VladxIL/NMEA2000_0183_Display/Media/CAN_DISPLAY.png

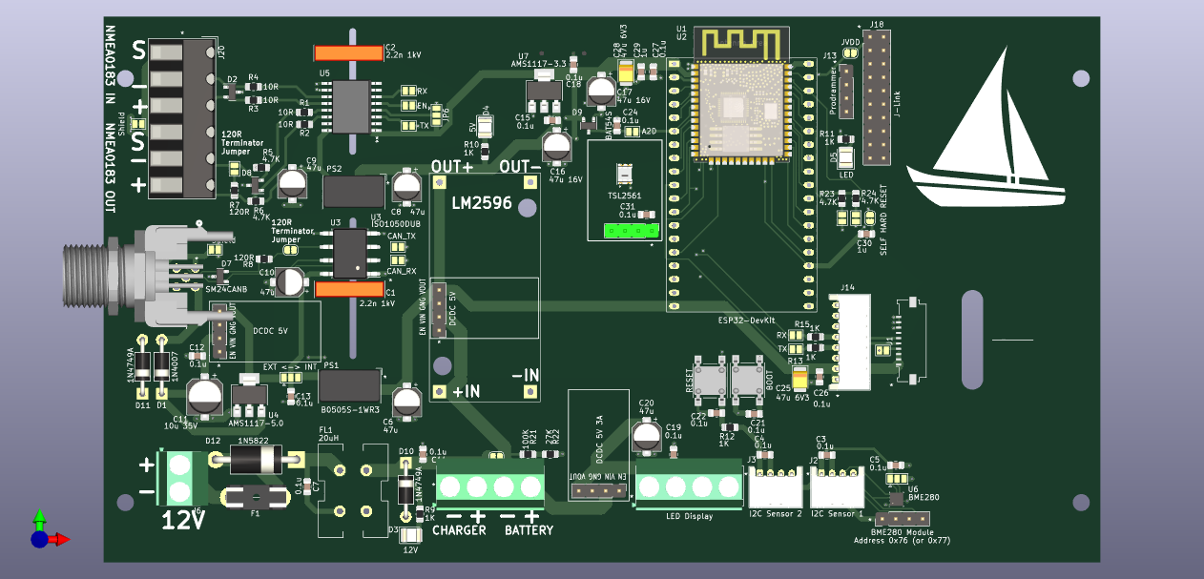
Media/CAN_DISPLAY.png
