VladxIL/NMEA2000_0183_Display/README.md

# NMEA2000_0183_Display
Display NMEA2000 and NMEA0183 on DWIN 7" Display
