VladxIL/NMEA2000_0183_Display/VersionsInfo.txt

Hardware Version 1.0 - PCB Release Candidate
	ESP32-WROOM-32
	Galvanic isolated CAN BUS
	Galvanic isolated RS422 Input and Output
	DWWIN UART interface.
1	
Firmware Version 1.0
	Not implemented yet
