VladxIL/NMEA2000_0183_Display/BOM/AUTOBOM LED Matrix Display.csv

Source: | C:\Vladi\MyProjects\NMEA2000_0183_Display\LED Matrix Display\LED Matrix Display.kicad_sch
Date: | 11/20/2023 10:49:28 AM
Tool: | Eeschema 7.0.8
Generator: | C:\Program Files\KiCad\7.0\bin\scripting\plugins/bom_csv_grouped_by_value_with_fp.py
Component Count: | 37
Ref | Qnty | Value | Cmp name | Footprint | Description | Vendor | DNP
C1 | 1 | 0.1uF | C_Small | Capacitor_SMD:C_0402_1005Metric | Unpolarized capacitor, small symbol
C2, C3, C5, C6, C8, C9, C13, C14, C15 | 9 | 0.1u | C_Small | Capacitor_SMD:C_0805_2012Metric_Pad1.18x1.45mm_HandSolder | Unpolarized capacitor, small symbol
C4, C10 | 2 | 1u | C_Small | Capacitor_SMD:C_0805_2012Metric_Pad1.18x1.45mm_HandSolder | Unpolarized capacitor, small symbol
C11 | 1 | 47u 6V3 | C_Polarized_Small | Capacitor_Tantalum_SMD:CP_EIA-3528-21_Kemet-B_Pad1.50x2.35mm_HandSolder | Polarized capacitor, small symbol
C12, C16 | 2 | 47u 16V | C_Polarized_Small | Capacitor_SMD:CP_Elec_5x5.8 | Polarized capacitor, small symbol
D1 | 1 | WS2812B | WS2812B | LED_SMD:LED_WS2812B_PLCC4_5.0x5.0mm_P3.2mm | RGB LED with integrated controller
D2 | 1 | BAT54S | BAT54S | Package_TO_SOT_SMD:SOT-23 | Vr 30V, If 200mA, Dual schottky barrier diode, in series, SOT-323
D3 | 1 | LED | LED_Small | LED_SMD:LED_0805_2012Metric_Pad1.15x1.40mm_HandSolder | Light emitting diode, small symbol
J1 | 1 | I2C Sensor 1 | Conn_01x04 | Connector_JST:JST_PH_S4B-PH-SM4-TB_1x04-1MP_P2.00mm_Horizontal | Generic connector, single row, 01x04, script generated (kicad-library-utils/schlib/autogen/connector/)
J2 | 1 | Prodrammer | Conn_01x04 | Connector_JST:JST_PH_S4B-PH-SM4-TB_1x04-1MP_P2.00mm_Horizontal | Generic connector, single row, 01x04, script generated (kicad-library-utils/schlib/autogen/connector/)
J4 | 1 | IN | Screw_Terminal_01x04 | Connector_Molex:Molex_Micro-Fit_3.0_43650-0415_1x04_P3.00mm_Vertical | Generic screw terminal, single row, 01x04, script generated (kicad-library-utils/schlib/autogen/connector/)
J6 | 1 | OUT | Screw_Terminal_01x04 | Connector_Molex:Molex_Micro-Fit_3.0_43650-0415_1x04_P3.00mm_Vertical | Generic screw terminal, single row, 01x04, script generated (kicad-library-utils/schlib/autogen/connector/)
J7 | 1 | MINI560 | Screw_Terminal_01x04 | 1Display:Mini560_DC_StepDown | Generic screw terminal, single row, 01x04, script generated (kicad-library-utils/schlib/autogen/connector/)
JP2 | 1 | SELF HARD RESET | SolderJumper_2_Open | Jumper:SolderJumper-2_P1.3mm_Open_RoundedPad1.0x1.5mm | Solder Jumper, 2-pole, open
LED1 | 1 | TSL2561 | TSL25723FN | 1Display:TSL2561
R1, R6 | 2 | 1K | R_Small | Resistor_SMD:R_0805_2012Metric_Pad1.20x1.40mm_HandSolder | Resistor, small symbol
R2, R3 | 2 | 4.7K | R_Small | Resistor_SMD:R_0805_2012Metric_Pad1.20x1.40mm_HandSolder | Resistor, small symbol
R4 | 1 | 100K | R_Small | Resistor_SMD:R_0805_2012Metric_Pad1.20x1.40mm_HandSolder | Resistor, small symbol
R5 | 1 | 27K | R_Small | Resistor_SMD:R_0805_2012Metric_Pad1.20x1.40mm_HandSolder | Resistor, small symbol
SW1 | 1 | BOOT | SW_Push | Button_Switch_SMD:SW_Push_1P1T_NO_6x6mm_H9.5mm | Push button switch, generic, two pins
SW2 | 1 | RESET | SW_Push | Button_Switch_SMD:SW_Push_1P1T_NO_6x6mm_H9.5mm | Push button switch, generic, two pins
SW3 | 1 | SW_Reed | SW_Reed | Button_Switch_SMD:SW_SPST_REED_CT05-XXXX-J1 | reed switch
U1 | 1 | ESP32-WROOM-E | ESP32-WROOM-E | PCM_Espressif:ESP32-WROOM-32E | ESP32-WROOM-32E integrates ESP32-D0WD-V3, with higher stability and safety performance.
U2 | 1 | BME280 | BME280 | Package_LGA:Bosch_LGA-8_2.5x2.5mm_P0.65mm_ClockwisePinNumbering | 3-in-1 sensor, humidity, pressure, temperature, I2C and SPI interface, 1.71-3.6V, LGA-8
U4 | 1 | AMS1117-3.3 | AMS1117-5.0 | Package_TO_SOT_SMD:SOT-223-3_TabPin2 | 1A Low Dropout regulator, positive, 5.0V fixed output, SOT-223
