VladxIL/NMEA2000_0183_Display/CAN_DISPLAY/Footprints/c-1977223-6-b1-3d.stp

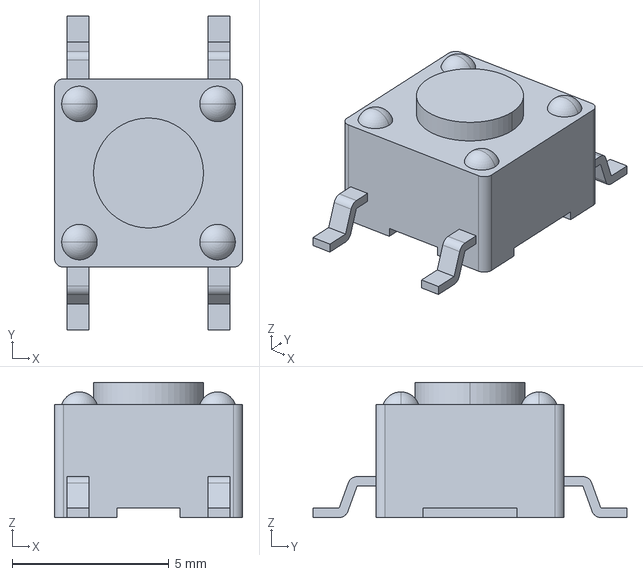
[picture p2: CAD file, 2023-11-14]
CAN_DISPLAY/Footprints/c-1977223-6-b1-3d.stp
6.00 x 10.0 x 4.30 mm
