VladxIL/NMEA2000_0183_Display/CAN_DISPLAY/Footprints/ul_ISO3080DW/DW0016B.stp

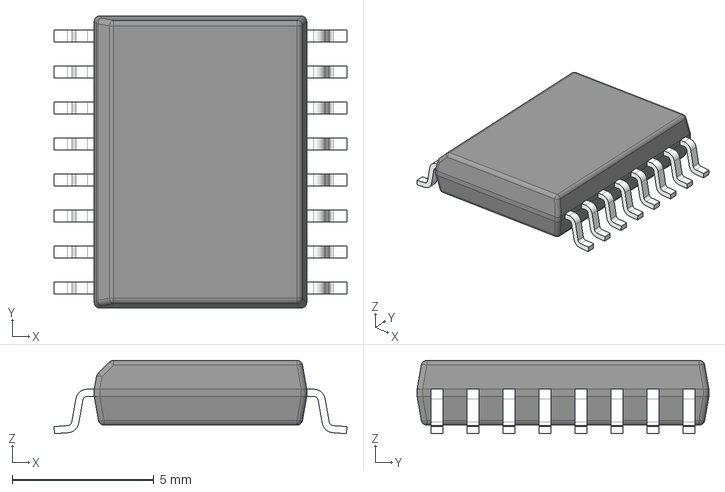
[picture p3: CAD file, 2023-11-12]
CAN_DISPLAY/Footprints/ul_ISO3080DW/DW0016B.stp
10.3 x 10.3 x 2.59 mm
BODY-SOIC
LEAD-DW0016 x 16
