VladxIL/NMEA2000_0183_Display/CAN_DISPLAY/Footprints/c-1825967-1-c-3d.stp

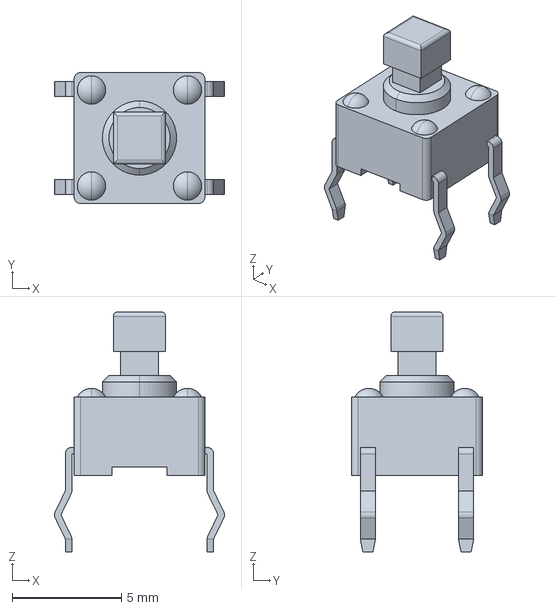
[picture p4: CAD file, 2023-11-14]
CAN_DISPLAY/Footprints/c-1825967-1-c-3d.stp
7.80 x 6.00 x 11.0 mm
