VladxIL/NMEA2000_0183_Display/CAN_DISPLAY/Footprints/M12.stp

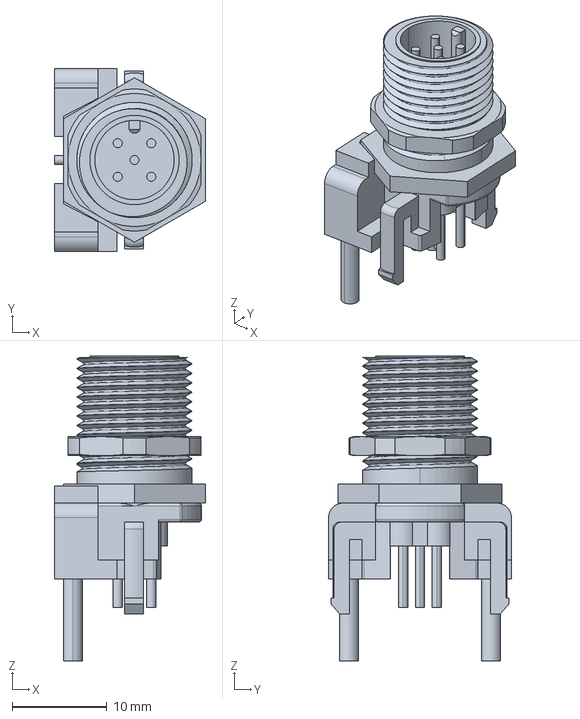
[picture p5: CAD file, 2023-11-14]
CAN_DISPLAY/Footprints/M12.stp
15.9 x 19.2 x 32.1 mm
