VladxIL/NMEA2000_0183_Display/CAN_DISPLAY/Footprints/Terminal4p.stp

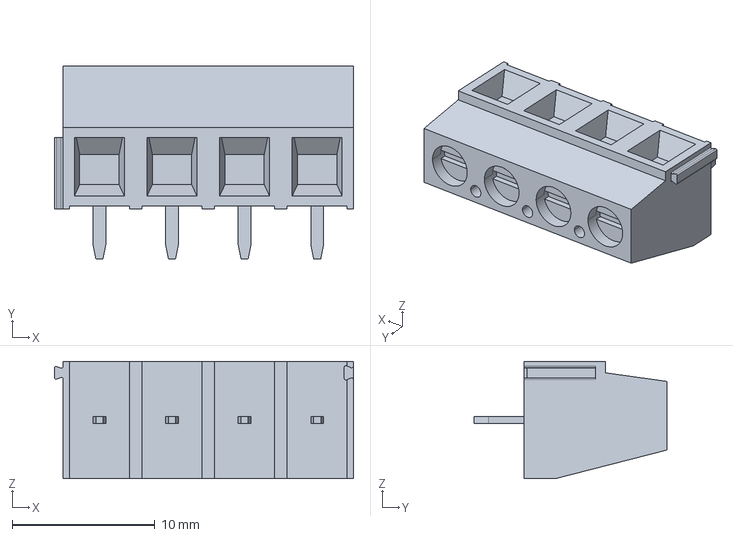
[picture p6: CAD file, 2023-11-14]
CAN_DISPLAY/Footprints/Terminal4p.stp
20.9 x 13.5 x 8.20 mm
