VladxIL/NMEA2000_0183_Display/Schematic/CAN_DISPLAY.pdf

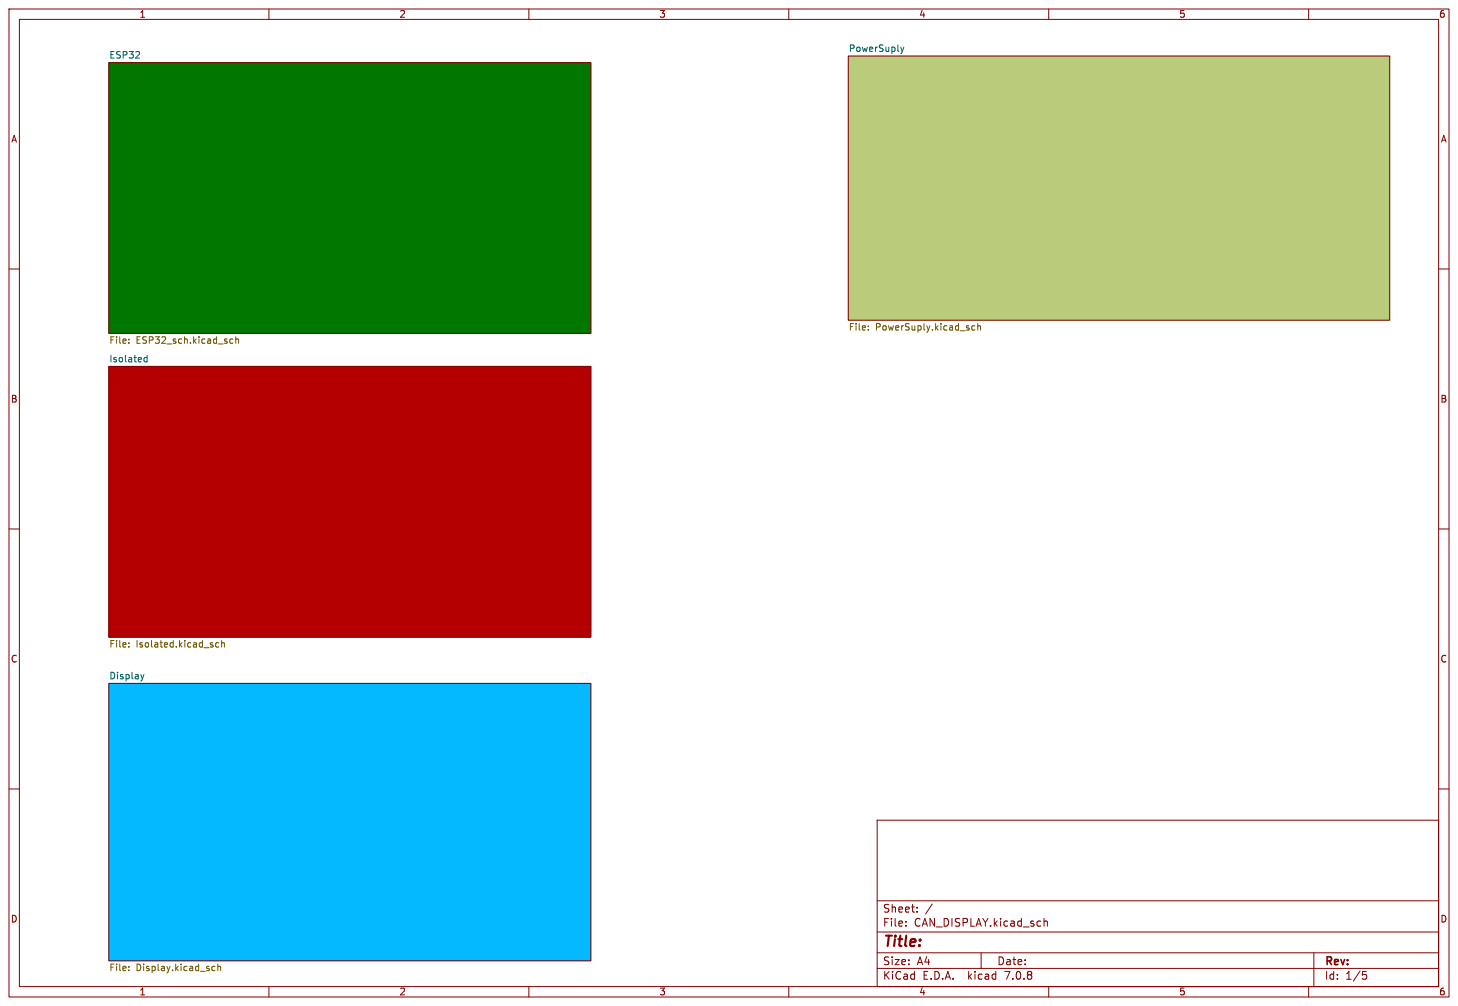
[picture p7: page 1]

PowerSuply File: PowerSuply.kicad_sch ESP32 File: ESP32_sch.kicad_sch Display File: Display.kicad_sch

Id: 1/5 Title: File: CAN_DISPLAY.kicad_sch Sheet: /

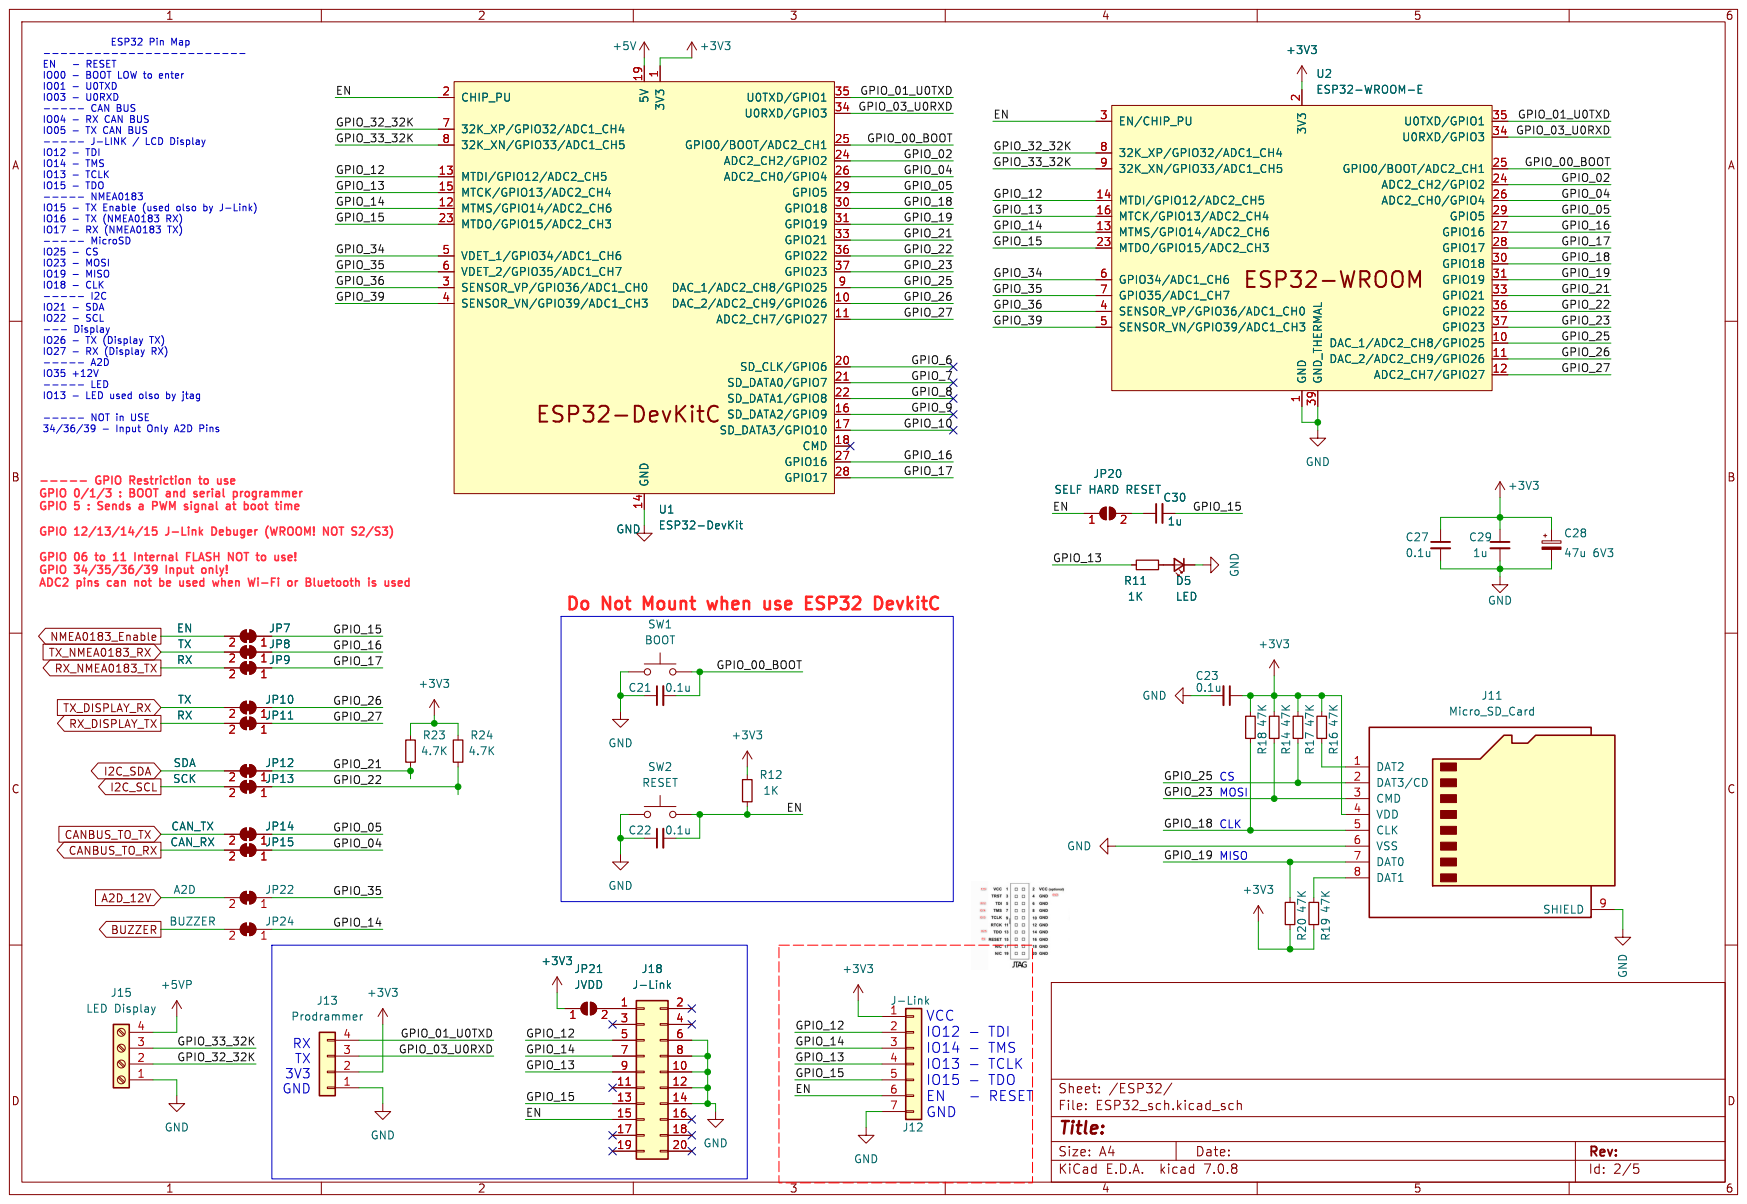
[picture p8: page 2]

1 DAC_2/ADC2_CH9/GPIO26 10 ADC2_CH7/GPIO27 11 MTMS/GPIO14/ADC2_CH6 12 MTDI/GPIO12/ADC2_CH5 13 MTCK/GPIO13/ADC2_CH4 15 SD_DATA2/GPIO9 16 SD_DATA3/GPIO10 17 CMD 18 CHIP_PU 2 SD_CLK/GPIO6 20 SD_DATA0/GPIO7 21 SD_DATA1/GPIO8 22 MTDO/GPIO15/ADC2_CH3 23 ADC2_CH2/GPIO2 24 GPIO0/BOOT/ADC2_CH1 25 ADC2_CH0/GPIO4 26 GPIO16 27 GPIO17 28 GPIO5 29 SENSOR_VP/GPIO36/ADC1_CH0 3 GPIO18 30 GPIO19 31 GPIO21 33 U0RXD/GPIO3 34 U0TXD/GPIO1 35 GPIO22 36 GPIO23 37 SENSOR_VN/GPIO39/ADC1_CH3 4 VDET_1/GPIO34/ADC1_CH6 5 VDET_2/GPIO35/ADC1_CH7 6

Do Not Mount when use ESP32 DevkitC

Id: 2/5 Title: File: ESP32_sch.kicad_sch Sheet: /ESP32/ R12

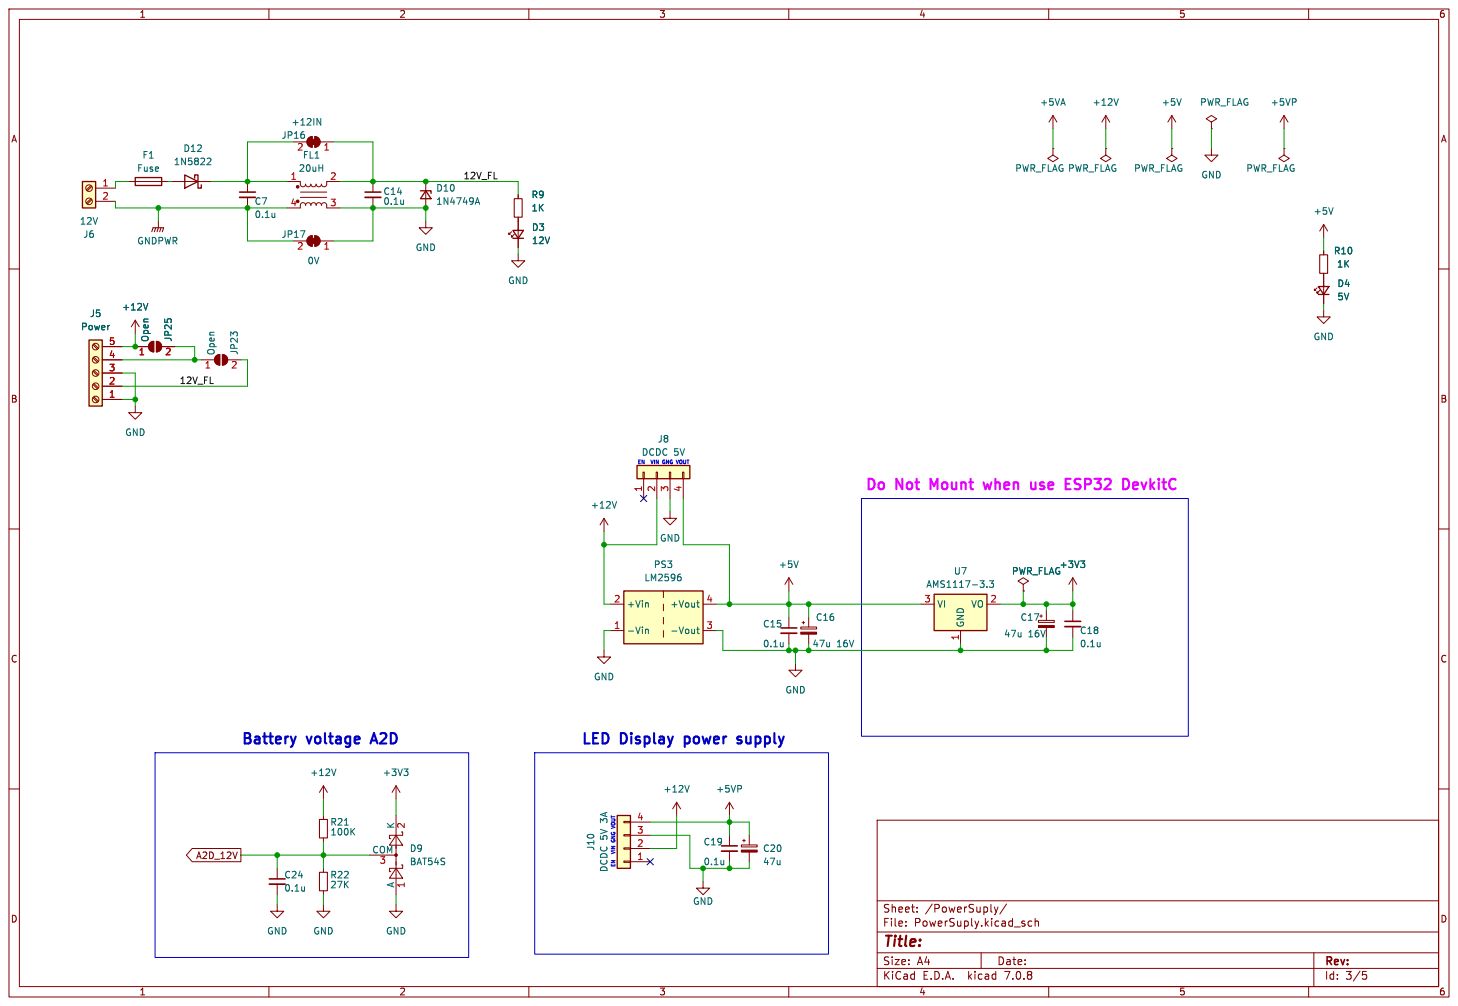
[picture p9: page 3]

Id: 3/5 Title: File: PowerSuply.kicad_sch Sheet: /PowerSuply/ GND GND

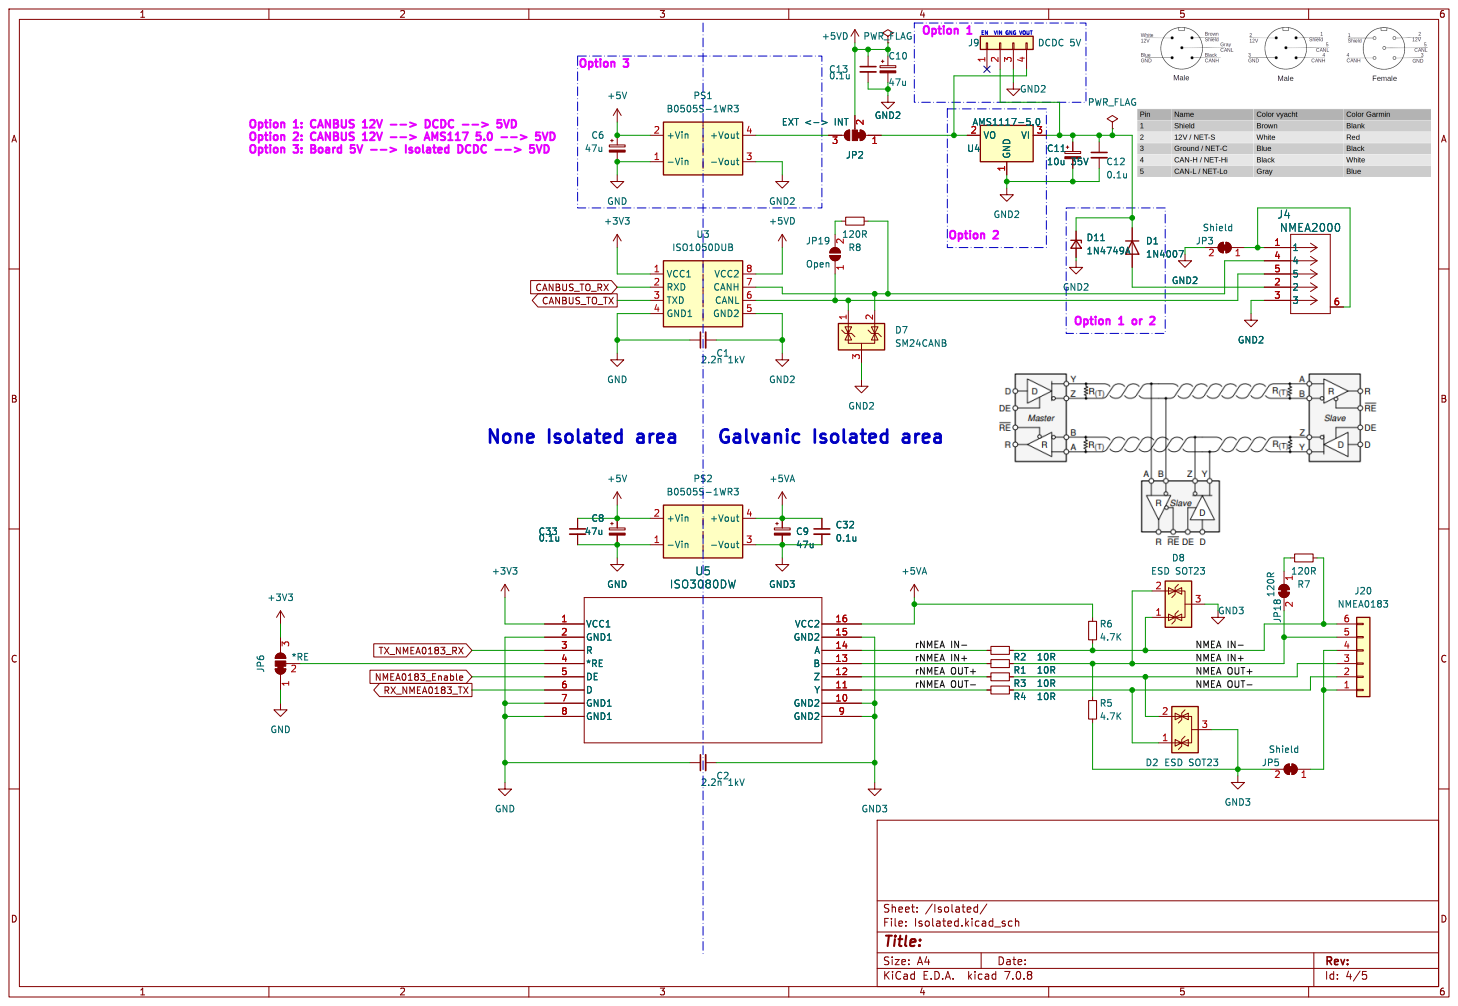
[picture p10: page 4]

1 VO 2 VI 3 U4AMS1117-5.0 VCC1 1 RXD 2 TXD 3 GND1 4 GND2 5 CANL 6 CANH 7 VCC2 8 U3

Id: 4/5 Title: File: Isolated.kicad_sch Sheet: /Isolated/ +3V3

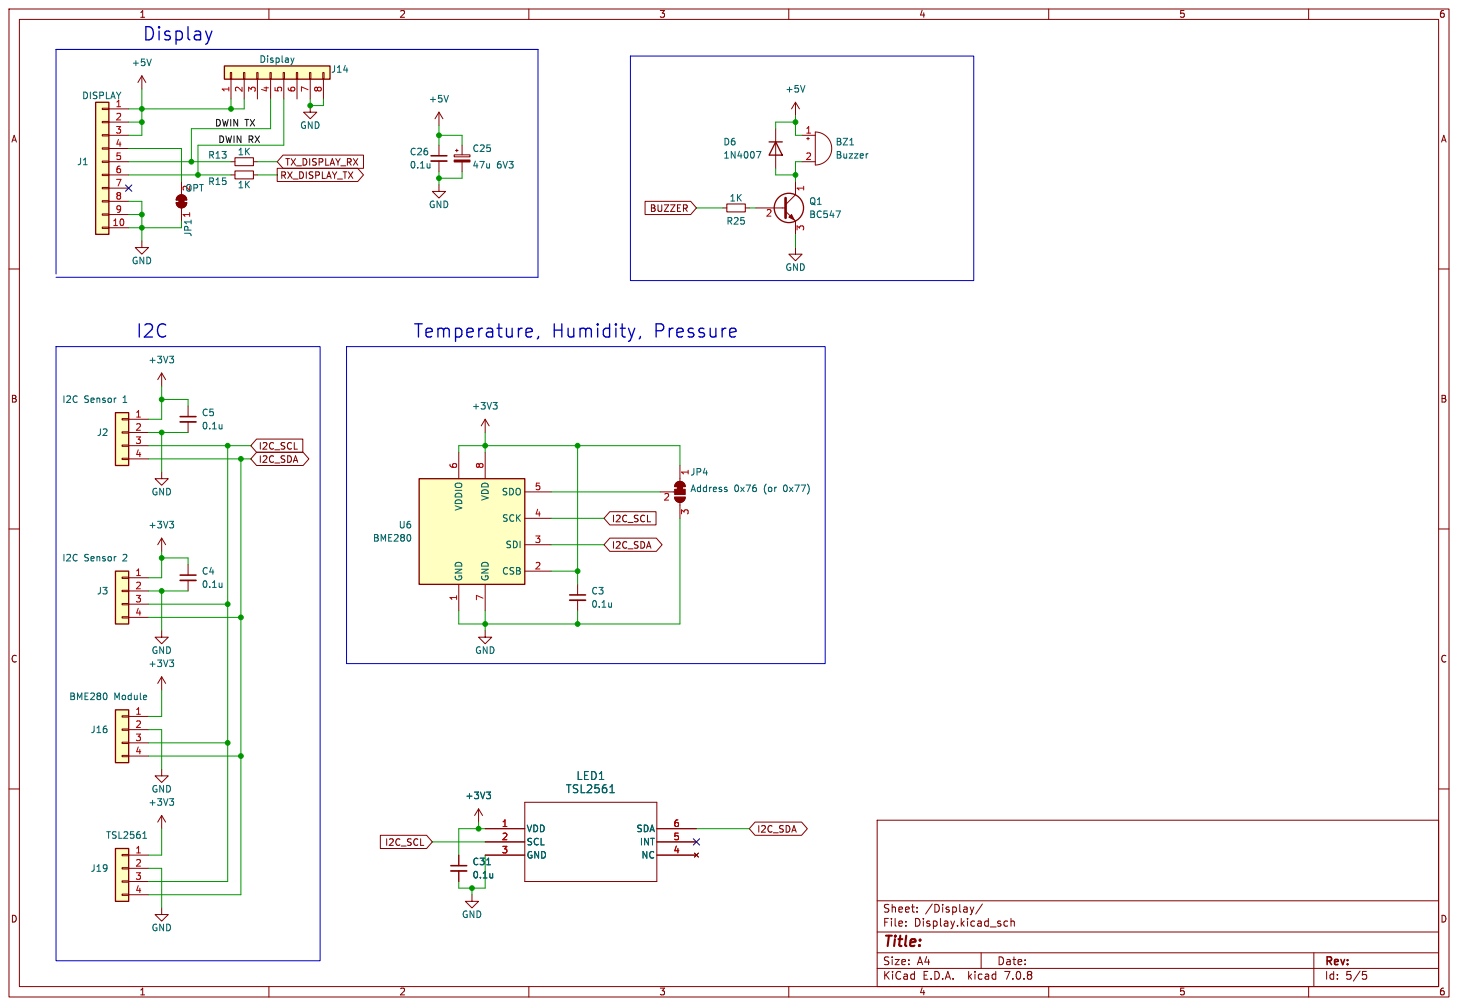
[picture p11: page 5]

DWIN RX DWIN TX

1 CSB 2 SDI 3 SCK 4 SDO 5 VDDIO

Id: 5/5 Title: File: Display.kicad_sch Sheet: /Display/
