VladxIL/NMEA2000_0183_Display/CAN_DISPLAY/CAN_DISPLAY.kicad_pcb

## KiCad design CAN_DISPLAY/CAN_DISPLAY.kicad_pcb (2023-11-15)

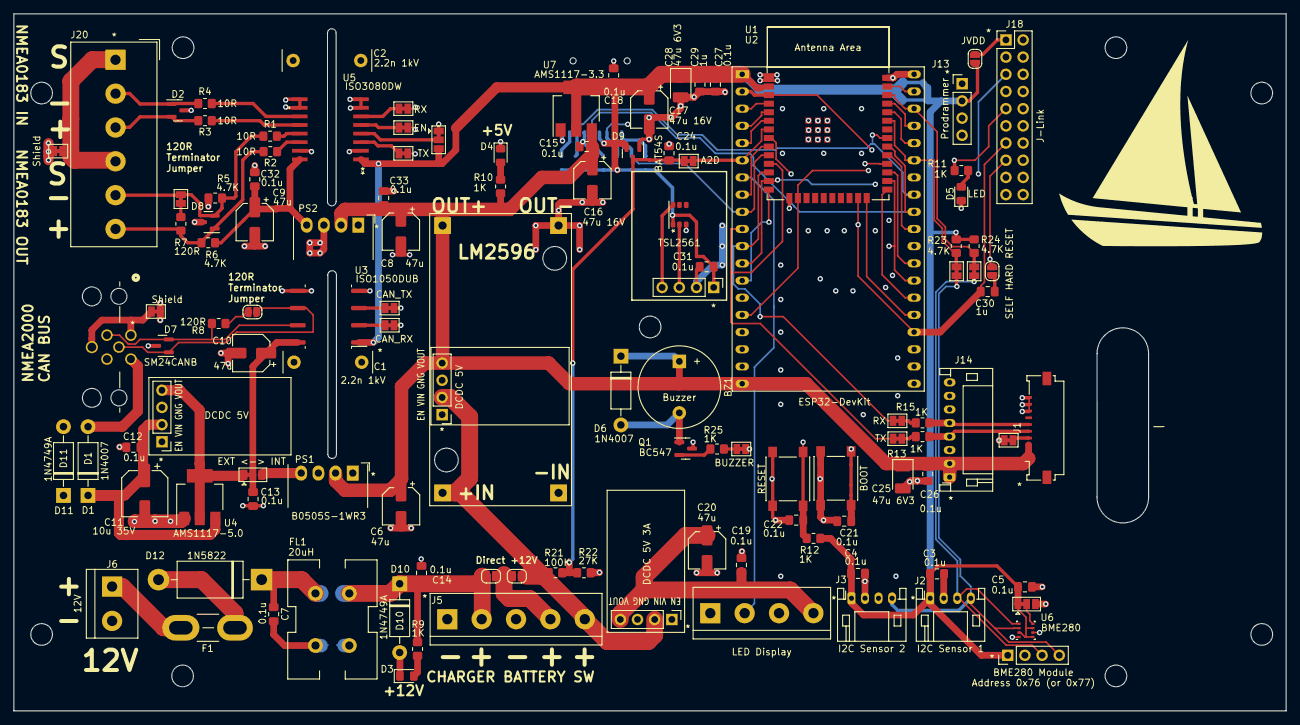
[picture p12: board CAN_DISPLAY.kicad_pcb from above]

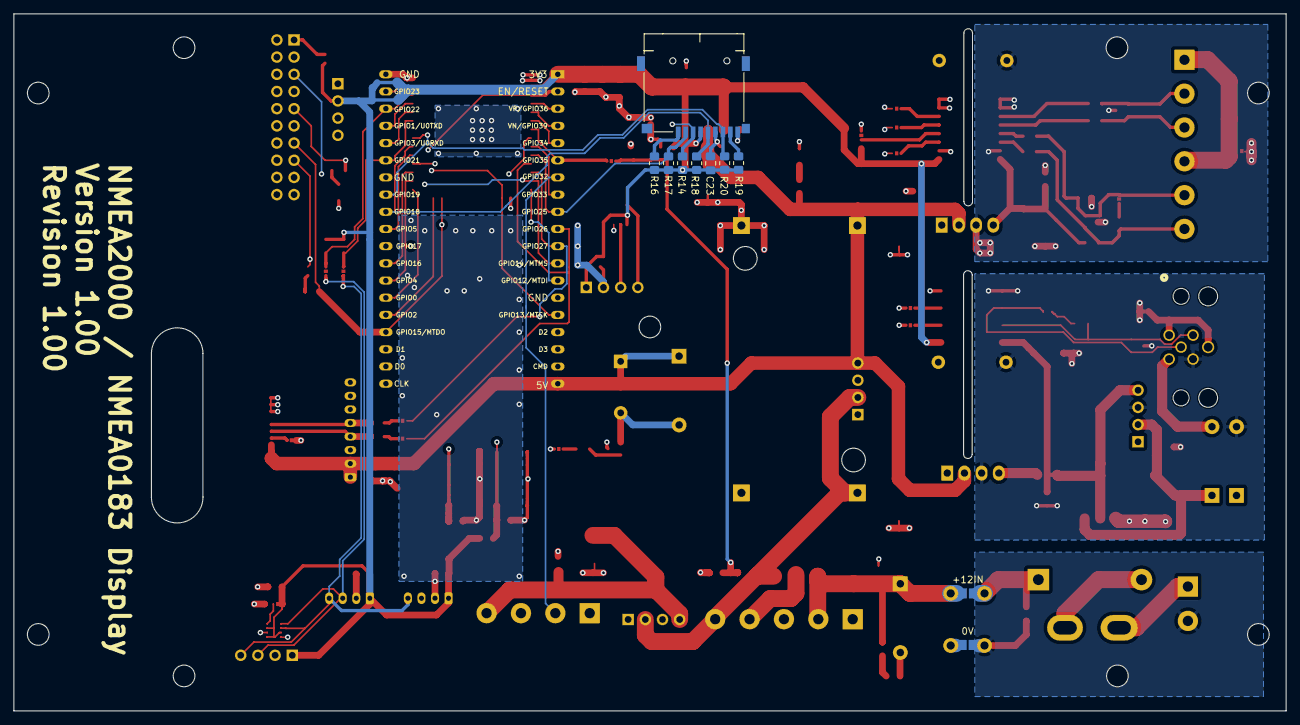
[picture p13: board CAN_DISPLAY.kicad_pcb from below]

Board: 4 copper layers, 188.0 x 103.0 mm, 129 parts (10 on the bottom side), 85 nets.

Parts:
BZ1: Buzzer; Buzzer_12x9.5RM7.6
C1, C2: 2.2n 1kV; C_Rect_L13.0mm_W3.0mm_P10.00mm_FKS3_FKP3_MKS4
C3, C4, C5, C7, C12, C13, C14, C15, C18, C19, C21, C22, C23, C24, C26, C27, C31, C32, C33: 0.1u; C_0805_2012Metric_Pad1.18x1.45mm_HandSolder
C6, C8, C9, C10, C20: 47u; CP_Elec_5x5.8
C11: 10u 35V; CP_Elec_6.3x4.5
C16, C17: 47u 16V; CP_Elec_5x5.8
C25, C28: 47u 6V3; CP_EIA-3528-21_Kemet-B_Pad1.50x2.35mm_HandSolder
C29, C30: 1u; C_0805_2012Metric_Pad1.18x1.45mm_HandSolder
D1, D6: 1N4007; D_DO-41_SOD81_P10.16mm_Horizontal
D2, D8: ESD SOT23; SOT-23
D3: 12V; LED_0805_2012Metric_Pad1.15x1.40mm_HandSolder
D4: 5V; LED_0805_2012Metric_Pad1.15x1.40mm_HandSolder
D5: LED; LED_0805_2012Metric_Pad1.15x1.40mm_HandSolder
D7: SM24CANB; SOT-23
D9: BAT54S; SOT-23
D10, D11: 1N4749A; D_DO-41_SOD81_P10.16mm_Horizontal
D12: 1N5822; D_DO-201AD_P15.24mm_Horizontal
F1: Fuse; Fuse_Blade_Mini_directSolder
FL1: 20uH; L_CommonMode_Wuerth_WE-CMB-S
J1: DISPLAY; Molex_200528-0100_1x10-1MP_P1.00mm_Horizontal
J2: I2C Sensor 1; JST_PH_S4B-PH-K_1x04_P2.00mm_Horizontal
J3: I2C Sensor 2; JST_PH_S4B-PH-K_1x04_P2.00mm_Horizontal
J4: NMEA2000; CONN5_43-01199_Vlad
J5: Power; TerminalBlock_bornier-5_P5.08mm
J6: 12V; TerminalBlock_bornier-2_P5.08mm
J8, J9: DCDC 5V; PinHeader_1x04_P2.54mm_Vertical
J10: DCDC 5V 3A; PinHeader_1x04_P2.54mm_Vertical
J11: Micro_SD_Card; J_SD_Card-micro_socket_A
J13: Prodrammer; PinHeader_1x04_P2.54mm_Vertical
J14: Display; JST_PH_S8B-PH-K_1x08_P2.00mm_Horizontal
J15: LED Display; TerminalBlock_bornier-4_P5.08mm
J16: BME280 Module; PinHeader_1x04_P2.54mm_Vertical
J18: J-Link; PinHeader_2x10_P2.54mm_Vertical
J19: TSL2561; PinHeader_1x04_P2.54mm_Vertical
J20: NMEA0183; Altech_AK300_1x06_P5.00mm_45-Degree
JP1: OPT; SolderJumper-2_P1.3mm_Bridged_Pad1.0x1.5mm
JP2: EXT <-> INT; SolderJumper-3_P1.3mm_Bridged12_Pad1.0x1.5mm
JP3, JP5: Shield; SolderJumper-2_P1.3mm_Bridged_Pad1.0x1.5mm
JP4: Address 0x76 (or 0x77); SolderJumper-3_P1.3mm_Bridged12_Pad1.0x1.5mm
JP6: *RE; SolderJumper-3_P1.3mm_Bridged12_Pad1.0x1.5mm
JP7: EN; SolderJumper-2_P1.3mm_Bridged_Pad1.0x1.5mm
JP8, JP10: TX; SolderJumper-2_P1.3mm_Bridged_Pad1.0x1.5mm
JP9, JP11: RX; SolderJumper-2_P1.3mm_Bridged_Pad1.0x1.5mm
JP12: SDA; SolderJumper-2_P1.3mm_Bridged_Pad1.0x1.5mm
JP13: SCK; SolderJumper-2_P1.3mm_Bridged_Pad1.0x1.5mm
JP14: CAN_TX; SolderJumper-2_P1.3mm_Bridged_Pad1.0x1.5mm
JP15: CAN_RX; SolderJumper-2_P1.3mm_Bridged_Pad1.0x1.5mm
JP16: +12IN; NOSILK SolderJumper-2_P1.3mm_Open_Pad1.0x1.5mm
JP17: 0V; NOSILK SolderJumper-2_P1.3mm_Open_Pad1.0x1.5mm
JP18: 120R; SolderJumper-2_P1.3mm_Bridged_Pad1.0x1.5mm
JP19, JP23, JP25: Open; SolderJumper-2_P1.3mm_Open_RoundedPad1.0x1.5mm
JP20: SELF HARD RESET; SolderJumper-2_P1.3mm_Open_RoundedPad1.0x1.5mm
JP21: JVDD; SolderJumper-2_P1.3mm_Open_RoundedPad1.0x1.5mm
JP22: A2D; SolderJumper-2_P1.3mm_Bridged_Pad1.0x1.5mm
JP24: BUZZER; SolderJumper-2_P1.3mm_Bridged_Pad1.0x1.5mm
LED1: TSL2561
PS1, PS2: B0505S-1WR3; Converter_DCDC_Murata_MEE1SxxxxSC_THT
PS3: LM2596; LM2596Module2
Q1: BC547; SOT-23
R1, R2, R3, R4: 10R; R_0805_2012Metric_Pad1.20x1.40mm_HandSolder
R5, R6, R23, R24: 4.7K; R_0805_2012Metric_Pad1.20x1.40mm_HandSolder
R7, R8: 120R; R_0805_2012Metric_Pad1.20x1.40mm_HandSolder
R9, R10, R11, R12, R13, R15, R25: 1K; R_0805_2012Metric_Pad1.20x1.40mm_HandSolder
R14, R16, R17, R18, R19, R20: 47K; R_0805_2012Metric_Pad1.20x1.40mm_HandSolder
R21: 100K; R_0805_2012Metric_Pad1.20x1.40mm_HandSolder
R22: 27K; R_0805_2012Metric_Pad1.20x1.40mm_HandSolder
SW1: BOOT; SW_Push_1P1T_NO_6x6mm_H9.5mm
SW2: RESET; SW_Push_1P1T_NO_6x6mm_H9.5mm
U1: ESP32-DevKit; ESP32-DevKitC
U2: ESP32-WROOM-E; ESP32-WROOM-32E
U3: ISO1050DUB; SOP-8_6.62x9.15mm_P2.54mm
U4: AMS1117-5.0; SOT-223-3_TabPin2
U5: ISO3080DW; DW16
U6: BME280; Bosch_LGA-8_2.5x2.5mm_P0.65mm_ClockwisePinNumbering
U7: AMS1117-3.3; SOT-223-3_TabPin2

Connections:
+3V3: C3.1, C4.1, C5.1, C17.1, C18.1, C23.1, C27.1, C28.1, C29.1, C31.1, D9.2 (K), J2.1, J3.1, J11.4 (VDD), J13.2, J16.1, J19.1, JP4.1 (A), JP6.3 (B), JP21.1 (A), LED1.1 (VDD), R12.2, R14.2, R16.2, R17.2, R18.2, R19.1, R20.1, R23.2, R24.2, U1.1 (3V3), U2.2 (3V3), U3.1 (VCC1), U5.1 (VCC1), U6.2 (CSB), U6.6 (VDDIO), U6.8 (VDD), U7.2 (VO)
+5V: BZ1.1 (-), C6.1, C8.1, C15.1, C16.1, C25.1, C26.1, C33.1, D6.1 (K), J1.1, J1.2, J1.3, J8.4, J14.1, J14.2, PS1.2 (+Vin), PS2.2 (+Vin), PS3.4 (+Vout), R10.2, U1.19 (5V), U7.3 (VI)
+5VA: C9.1, C32.1, PS2.4 (+Vout), R6.2, U5.16 (VCC2)
+5VD: C10.1, C13.1, JP2.2 (C), U3.8 (VCC2)
+5VP: C19.1, C20.1, J10.4, J15.4
+12V: J5.5, J8.2, J10.2, JP25.1 (A), PS3.2 (+Vin), R21.2
/Display/DWIN RX: J1.6, J14.5, R15.1
/Display/DWIN TX: J1.5, J14.4, R13.2
/ESP32/EN: C22.2, J18.15, JP20.1 (A), R12.1, SW2.2, U1.2 (CHIP_PU), U2.3 (EN/CHIP_PU)
/ESP32/GPIO_00_BOOT: C21.2, SW1.2, U1.25 (GPIO0/BOOT/ADC2_CH1), U2.25 (GPIO0/BOOT/ADC2_CH1)
/ESP32/GPIO_01_U0TXD: J13.4, U1.35 (U0TXD/GPIO1), U2.35 (U0TXD/GPIO1)
/ESP32/GPIO_02: U1.24 (ADC2_CH2/GPIO2), U2.24 (ADC2_CH2/GPIO2)
/ESP32/GPIO_03_U0RXD: J13.3, U1.34 (U0RXD/GPIO3), U2.34 (U0RXD/GPIO3)
/ESP32/GPIO_04: JP15.1 (A), U1.26 (ADC2_CH0/GPIO4), U2.26 (ADC2_CH0/GPIO4)
/ESP32/GPIO_05: JP14.1 (A), U1.29 (GPIO5), U2.29 (GPIO5)
/ESP32/GPIO_12: J18.5, U1.13 (MTDI/GPIO12/ADC2_CH5), U2.14 (MTDI/GPIO12/ADC2_CH5)
/ESP32/GPIO_13: J18.9, R11.2, U1.15 (MTCK/GPIO13/ADC2_CH4), U2.16 (MTCK/GPIO13/ADC2_CH4)
/ESP32/GPIO_14: J18.7, JP24.1 (A), U1.12 (MTMS/GPIO14/ADC2_CH6), U2.13 (MTMS/GPIO14/ADC2_CH6)
/ESP32/GPIO_15: C30.2, J18.13, JP7.1 (A), U1.23 (MTDO/GPIO15/ADC2_CH3), U2.23 (MTDO/GPIO15/ADC2_CH3)
/ESP32/GPIO_16: JP8.1 (A), U1.27 (GPIO16), U2.27 (GPIO16)
/ESP32/GPIO_17: JP9.1 (A), U1.28 (GPIO17), U2.28 (GPIO17)
/ESP32/GPIO_18: J11.5 (CLK), R18.1, U1.30 (GPIO18), U2.30 (GPIO18)
/ESP32/GPIO_19: J11.7 (DAT0), R20.2, U1.31 (GPIO19), U2.31 (GPIO19)
/ESP32/GPIO_21: JP12.1 (A), R23.1, U1.33 (GPIO21), U2.33 (GPIO21)
/ESP32/GPIO_22: JP13.1 (A), R24.1, U1.36 (GPIO22), U2.36 (GPIO22)
/ESP32/GPIO_23: J11.3 (CMD), R14.1, U1.37 (GPIO23), U2.37 (GPIO23)
/ESP32/GPIO_25: J11.2 (DAT3/CD), R17.1, U1.9 (DAC_1/ADC2_CH8/GPIO25), U2.10 (DAC_1/ADC2_CH8/GPIO25)
/ESP32/GPIO_26: JP10.1 (A), U1.10 (DAC_2/ADC2_CH9/GPIO26), U2.11 (DAC_2/ADC2_CH9/GPIO26)
/ESP32/GPIO_27: JP11.1 (A), U1.11 (ADC2_CH7/GPIO27), U2.12 (ADC2_CH7/GPIO27)
/ESP32/GPIO_32_32K: J15.2, U1.7 (32K_XP/GPIO32/ADC1_CH4), U2.8 (32K_XP/GPIO32/ADC1_CH4)
/ESP32/GPIO_33_32K: J15.3, U1.8 (32K_XN/GPIO33/ADC1_CH5), U2.9 (32K_XN/GPIO33/ADC1_CH5)
/ESP32/GPIO_34: U1.5 (VDET_1/GPIO34/ADC1_CH6), U2.6 (GPIO34/ADC1_CH6)
/ESP32/GPIO_35: JP22.1 (A), U1.6 (VDET_2/GPIO35/ADC1_CH7), U2.7 (GPIO35/ADC1_CH7)
/ESP32/GPIO_36: U1.3 (SENSOR_VP/GPIO36/ADC1_CH0), U2.4 (SENSOR_VP/GPIO36/ADC1_CH0)
/ESP32/GPIO_39: U1.4 (SENSOR_VN/GPIO39/ADC1_CH3), U2.5 (SENSOR_VN/GPIO39/ADC1_CH3)
/Isolated/NMEA IN+: D2.2 (K), J20.3, R3.2
/Isolated/NMEA IN-: D2.1 (K), J20.2, R4.2
/Isolated/NMEA OUT+: D8.1 (K), J20.6, R2.2, R6.1, R7.2
/Isolated/NMEA OUT-: D8.2 (K), J20.5, JP18.2 (B), R1.2, R5.2
/PowerSuply/12V_FL: C14.1, D10.1 (K), FL1.2, J5.2, JP16.1 (A), JP23.2 (B), R9.2
A2D_12V: C24.1, D9.3 (COM), JP22.2 (B), R21.1, R22.2
BUZZER: JP24.2 (B), R25.2
CANBUS_TO_RX: JP15.2 (B), U3.2 (RXD)
CANBUS_TO_TX: JP14.2 (B), U3.3 (TXD)
GND: C1.1, C2.1, C3.2, C4.2, C5.2, C6.2, C8.2, C14.2, C15.2, C16.2, C17.2, C18.2, C19.2, C20.2, C21.1, C22.1, C23.2, C24.2, C25.2, C26.2, C27.2, C28.2, C29.2, C31.2, C33.2, D3.1 (K), D4.1 (K), D5.1 (K), D9.1 (A), D10.2 (A), FL1.3, J1.8, J1.9, J1.10, J2.2, J3.2, J5.1, J5.3, J8.3, J10.3, J11.6 (VSS), J11.9 (SHIELD), J13.1, J14.7, J14.8, J15.1, J16.2, J18.6, J18.8, J18.10, J18.12, J18.14, J19.2, JP1.1 (A), JP4.3 (B), JP6.1 (A), JP17.1 (A), LED1.3 (GND), PS1.1 (-Vin), PS2.1 (-Vin), PS3.1 (-Vin), PS3.3 (-Vout), Q1.3 (E), R22.1, SW1.1, SW2.1, U1.14 (GND), U1.32 (GND), U1.38 (GND), U2.1 (GND), U2.15 (GND), U2.38 (GND), U2.39 (GND_THERMAL), U3.4 (GND1), U5.2 (GND1), U5.7 (GND1), U5.8 (GND1), U6.1 (GND), U6.7 (GND), U7.1 (GND)
GND2: C1.2, C10.2, C11.2, C12.2, C13.2, D7.3 (A), D11.2 (A), J4.3, J9.3, JP3.2 (B), PS1.3 (-Vout), U3.5 (GND2), U4.1 (GND)
GND3: C2.2, C9.2, C32.2, D2.3 (A), D8.3 (A), JP5.2 (B), PS2.3 (-Vout), R5.1, U5.9 (GND2), U5.10 (GND2), U5.15 (GND2)
GNDPWR: C7.2, FL1.4, J6.2, JP17.2 (B)
I2C_SCL: J2.3, J3.3, J16.3, J19.3, JP13.2 (B), LED1.2 (SCL), U6.4 (SCK)
I2C_SDA: J2.4, J3.4, J16.4, J19.4, JP12.2 (B), LED1.6 (SDA), U6.3 (SDI)
NMEA0183_Enable: JP7.2 (B), U5.5 (DE)
unnamed: BZ1.2 (+), D6.2 (A), Q1.1 (C)
unnamed: D1.2 (A), J4.2
unnamed: C11.1, C12.1, D1.1 (K), D11.1 (K), J9.2, U4.3 (VI)
unnamed: D3.2 (A), R9.1
unnamed: D4.2 (A), R10.1
unnamed: D5.2 (A), R11.1
unnamed: D12.2 (A), F1.2
unnamed: C7.1, D12.1 (K), FL1.1, JP16.2 (B)
unnamed: J1.4, JP1.2 (B)
unnamed: J5.4, JP23.1 (A), JP25.2 (B)
unnamed: F1.1, J6.1
unnamed: J9.4, JP2.1 (A), U4.2 (VO)
unnamed: J11.8 (DAT1), R19.2
unnamed: J11.1 (DAT2), R16.1
unnamed: J18.1, JP21.2 (B)
unnamed: J20.1, J20.4, JP5.1 (A)
unnamed: JP2.3 (B), PS1.4 (+Vout)
unnamed: J4.1, J4.6, JP3.1 (A)
unnamed: JP4.2 (C), U6.5 (SDO)
unnamed: JP6.2 (C), U5.4 (*RE)
unnamed: JP18.1 (A), R7.1
unnamed: D7.1 (K), J4.5, JP19.1 (A), U3.6 (CANL)
unnamed: JP19.2 (B), R8.1
unnamed: C30.1, JP20.2 (B)
unnamed: Q1.2 (B), R25.1
unnamed: D7.2 (K), J4.4, R8.2, U3.7 (CANH)
unnamed: R2.1, U5.14 (A)
unnamed: R1.1, U5.13 (B)
unnamed: R4.1, U5.11 (Y)
unnamed: R3.1, U5.12 (Z)
RX_DISPLAY_TX: JP11.2 (B), R15.2
RX_NMEA0183_TX: JP9.2 (B), U5.6 (D)
TX_DISPLAY_RX: JP10.2 (B), R13.1
TX_NMEA0183_RX: JP8.2 (B), U5.3 (R)
