VladxIL/NMEA2000_0183_Display/(commit log)

2023-11-12 KiCad Project
    [CAN_DISPLAY.kicad_pcb, CAN_DISPLAY.kicad_sch, DW0016B.stp, Display.kicad_sch, ESP32_sch.kicad_sch, Isolated.kicad_sch, PowerSuply.kicad_sch]
2023-11-13 PCB Fixes
    [CAN_DISPLAY.kicad_pcb, Display.kicad_sch, ESP32_sch.kicad_sch, PowerSuply.kicad_sch]
2023-11-13 Add Ambient Light
    [CAN_DISPLAY.kicad_pcb, Display.kicad_sch, PowerSuply.kicad_sch]
2023-11-14 Added Light Sensor
    [CAN_DISPLAY.kicad_pcb, Display.kicad_sch, Isolated.kicad_sch, M12.stp, PowerSuply.kicad_sch, Terminal4p.stp, c-1825967-1-c-3d.stp, c-1977223-6-b1-3d.stp]
2023-11-15 Add SW
    [CAN_DISPLAY.kicad_pcb, Display.kicad_sch, ESP32_sch.kicad_sch, Isolated.kicad_sch, PowerSuply.kicad_sch]
2023-11-15 Comments CAN bus Power
    [Isolated.kicad_sch]
2023-11-15 Release Version 1.00 Rev 1.00
    [CAN_DISPLAY.kicad_pcb, ESP32_sch.kicad_sch, Isolated.kicad_sch]
2023-11-15 Gerber files
    [CAN_DISPLAY-B_Cu.gbr, CAN_DISPLAY-B_Mask.gbr, CAN_DISPLAY-B_Paste.gbr, CAN_DISPLAY-B_Silkscreen.gbr, CAN_DISPLAY-Edge_Cuts.gbr, CAN_DISPLAY-F_Cu.gbr, CAN_DISPLAY-F_Mask.gbr, CAN_DISPLAY-F_Paste.gbr]
2023-11-17 Added Led Matrix project
    [LED Matrix Display.kicad_sch]
2023-11-18 added esp32
    [LED Matrix Display.kicad_sch]
2023-11-19 LED MX Release candidate
    [ESP32.kicad_sch, LED Matrix Display.kicad_sch, LEDS Only.kicad_sch]
2023-11-20 Added BOM and Gerber files
    [AUTOBOM LED Matrix Display.csv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]
2023-12-12 Added Board Test
    [CAN_DISPLAY.kicad_pcb, Isolated.kicad_sch]
2023-12-12 Added I2C sensors tests to board test FW
2023-12-12 Test Board FW Added VIN check
